wanderingmoose/Airline-7-Segment-Clock/README.md

# Airline-7-Segment-Clock
Simple LED 7 segment clock with temperature
FAUX Neon Display Clock using 3d printed filters and Air line.
