wanderingmoose/Airline-7-Segment-Clock/20200501_225433-800.jpg

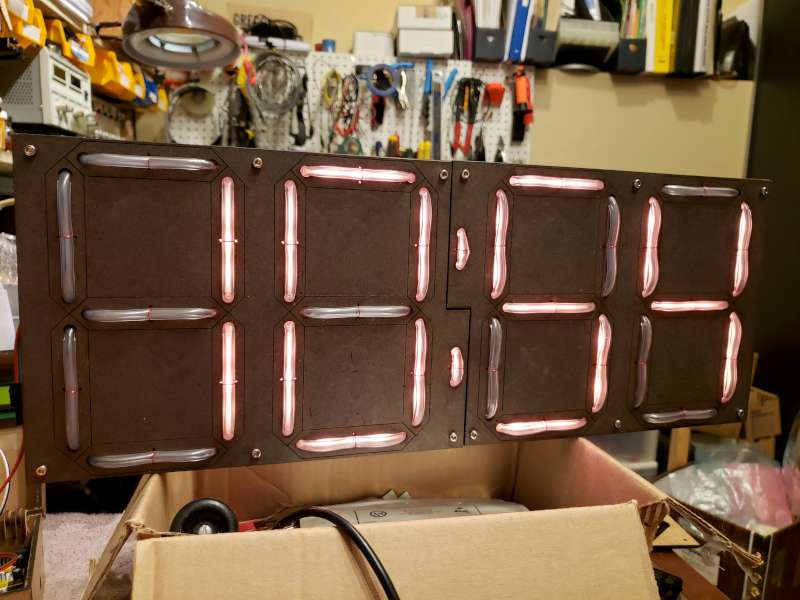
20200501_225433-800.jpg
