wanderingmoose/Airline-7-Segment-Clock/docs/picture/20200411_102533-800.jpg

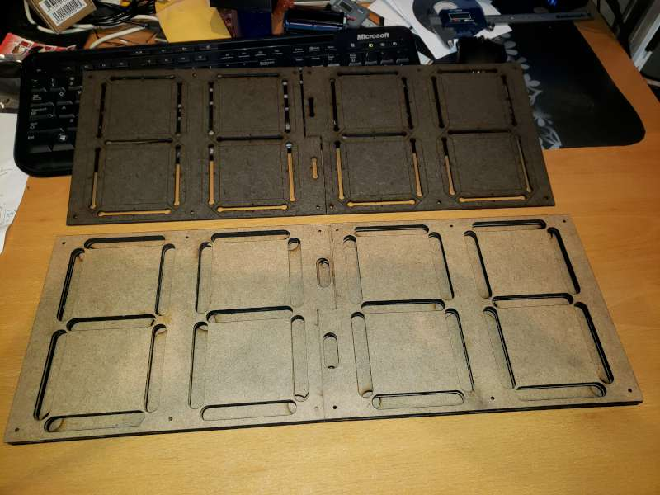
docs/picture/20200411_102533-800.jpg
