wanderingmoose/Airline-7-Segment-Clock/docs/picture/20200412_140959-800.jpg

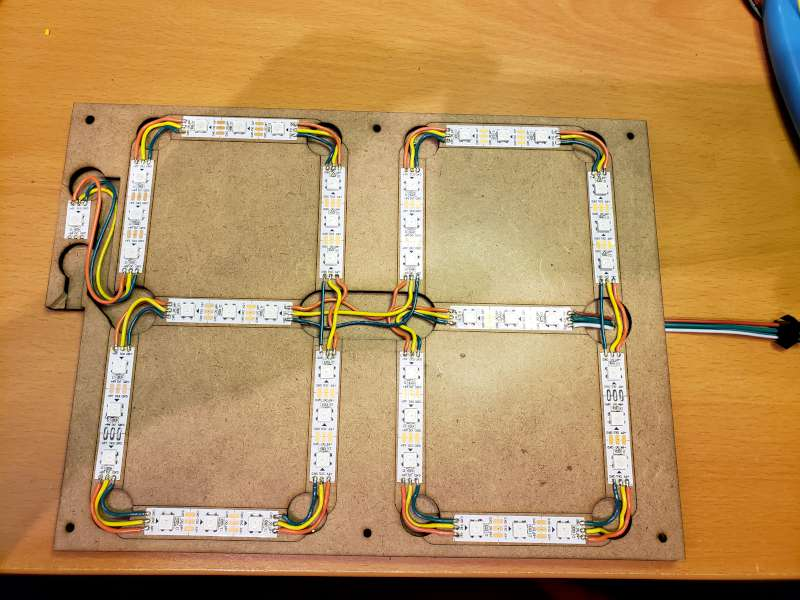
docs/picture/20200412_140959-800.jpg
