wanderingmoose/Airline-7-Segment-Clock/docs/picture/20200412_141007-800.jpg

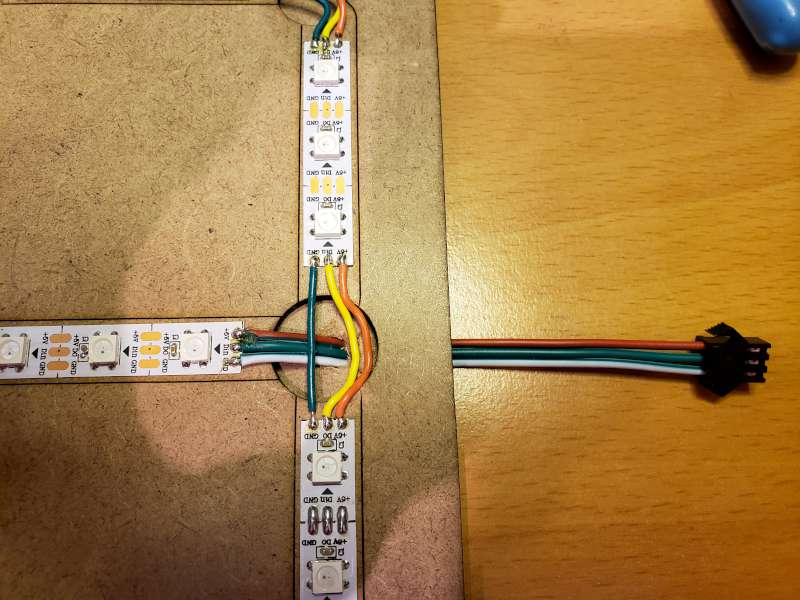
docs/picture/20200412_141007-800.jpg
