wanderingmoose/Airline-7-Segment-Clock/docs/picture/20200412_150223-800.jpg

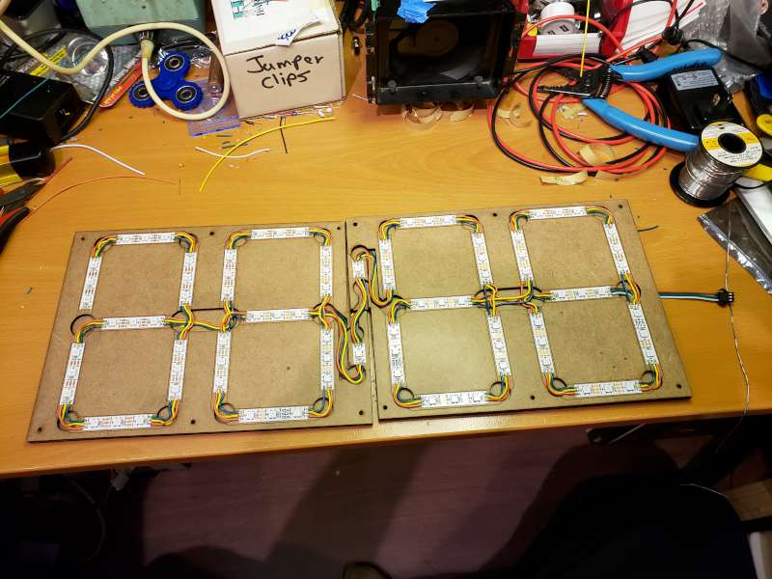
docs/picture/20200412_150223-800.jpg
