wanderingmoose/Airline-7-Segment-Clock/docs/picture/20200501_234732-800.jpg

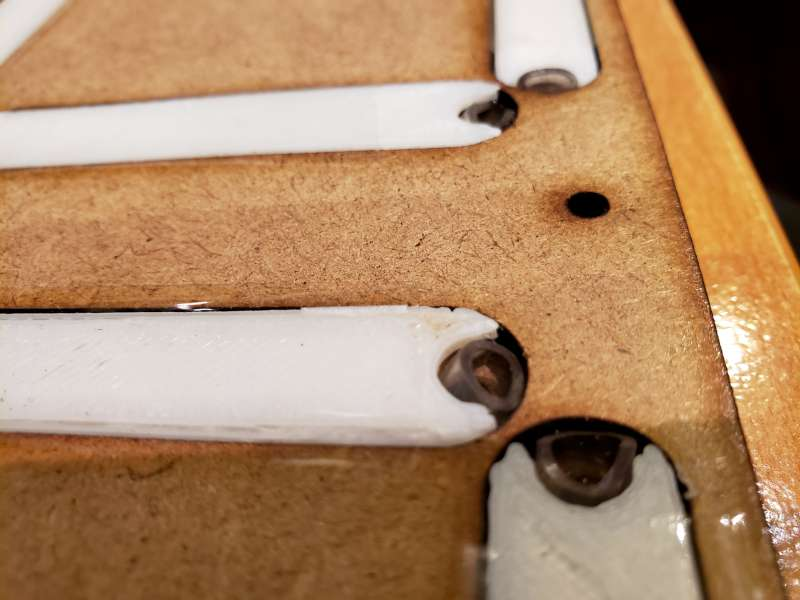
docs/picture/20200501_234732-800.jpg
