wanderingmoose/Airline-7-Segment-Clock/3D Printer/FAUX NEON LED Shade Lge V6.stl

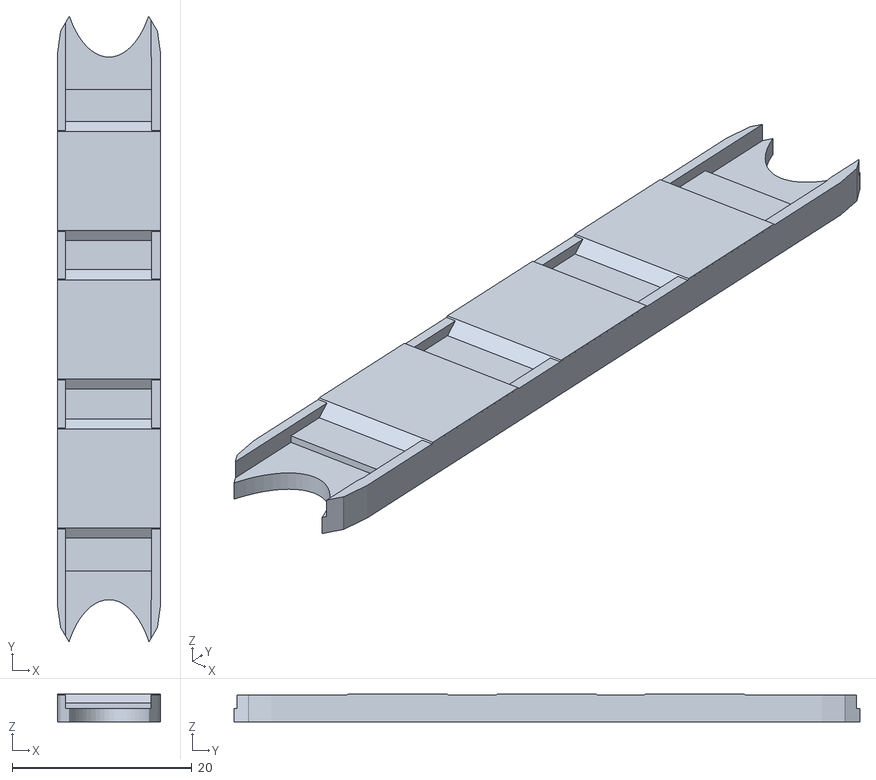
[picture p28: CAD file, 2020-06-30]
3D Printer/FAUX NEON LED Shade Lge V6.stl
11.5 x 69.7 x 3.10
