wanderingmoose/Airline-7-Segment-Clock/3D Printer/FAUX NEON LED Shade Sml V4.stl

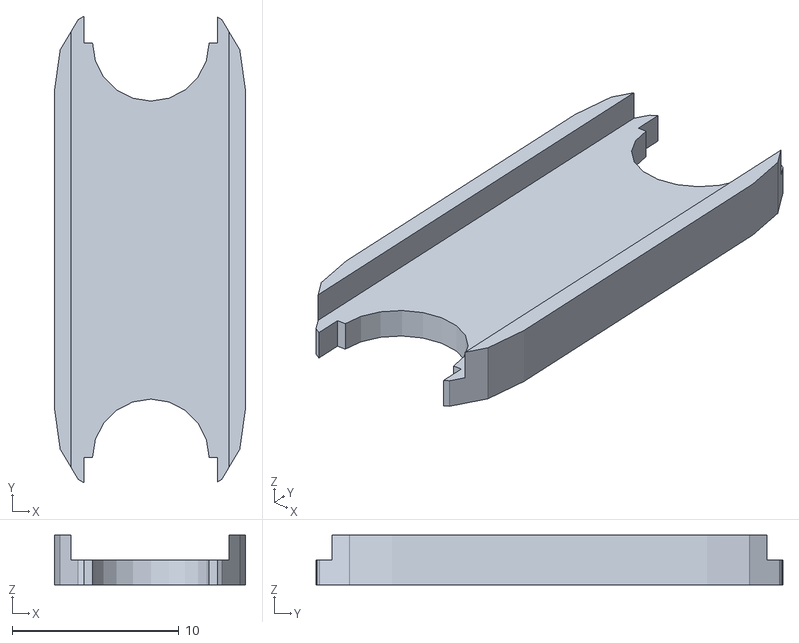
[picture p29: CAD file, 2020-06-30]
3D Printer/FAUX NEON LED Shade Sml V4.stl
11.5 x 28.0 x 3.00
