wanderingmoose/Airline-7-Segment-Clock/3D Printer/FAUX NEON LED Shade Lge V4.stl

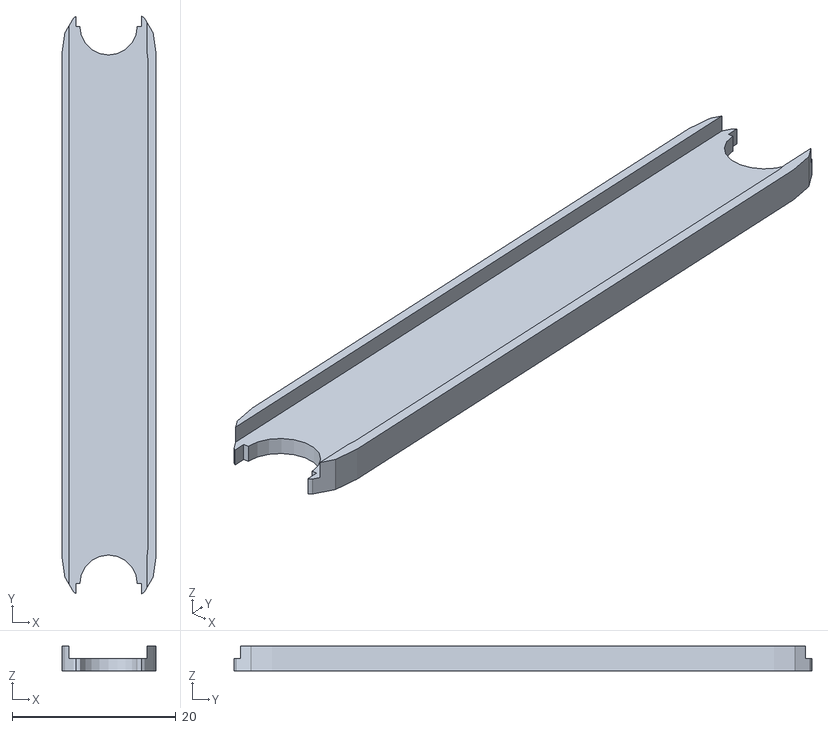
[picture p30: CAD file, 2020-06-30, an earlier design]
3D Printer/FAUX NEON LED Shade Lge V4.stl
11.5 x 70.5 x 3.00
