wanderingmoose/Airline-7-Segment-Clock/3D Printer/FAUX NEON LED Shade Lge V5.stl

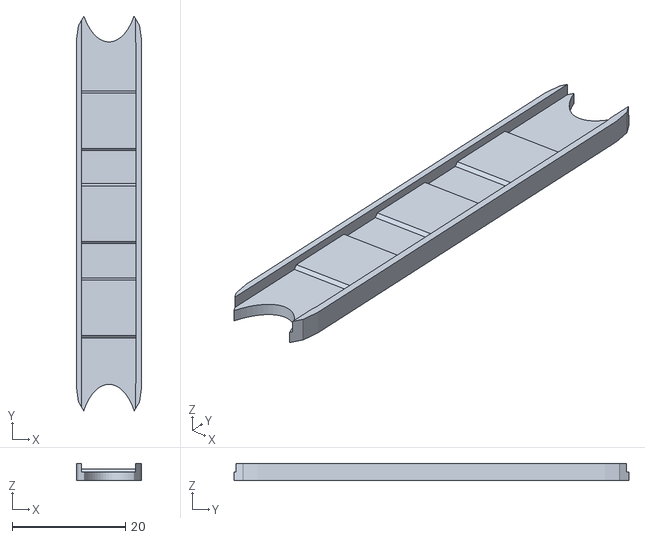
[picture p31: CAD file, 2020-06-30, an earlier design]
3D Printer/FAUX NEON LED Shade Lge V5.stl
11.5 x 69.7 x 3.00
