wanderingmoose/Airline-7-Segment-Clock/(list of files, cad)

Other CAD files:
3D Printer/fake.stl
